jscrane/TinySensors/mqtt-tft/README.md

# MQTT-TFT
Graphical display of MQTT sensors.

## Hardware
Display hardware as [WifiWeatherGuy](https://cadlab.io/project/1280/master/files):
- [Wemos D1 Mini](https://wiki.wemos.cc/products:d1:d1_mini)
- PCB-mounted push switch
- 1.8" TFT LCD display

## Software
- [Arduino](https://www.arduino.cc/en/main/software) 1.8.x
- [Arduino/ESP8266](https://github.com/esp8266/Arduino) 2.7.4
- [ArduinoJson](https://arduinojson.org) 6.16.1
- [TFT_eSPI](https://github.com/Bodmer/TFT_eSPI) 2.2.20
- [SimpleTimer](https://github.com/schinken/SimpleTimer)
- [Stator](https://github.com/PTS93/Stator)
