jscrane/TinySensors/(threads)

Thread 1 (2018-05-24):

cleanup socket handling

jscrane, 2018-05-24:
Fix mux in same way as lcd in commit 83f410cbb7785c234b9e89145b753e38b5866409

Closed 2018-05-25.

Thread 2 (2019-02-18):

Tinysensor sketch improvements

jscrane, 2019-02-18:
- [x] remove pinMode for A1 (not needed)
- [x] remove setAutoAck (not needed)
- [x] constants for ports
- [x] pinMode(A1, INPUT_PULLUP)
- [x] fix sensortest sketch
- [x] setMaxRetries (to save batteries) --- use sensortest
- [x] use Interrupted instead of sleepy

jscrane, 2019-06-12:
See [this article](https://lastminuteengineers.com/nrf24l01-arduino-wireless-communication/) for some tips. In particular:
- maybe don't use RF24Network at all?
- channel frequency (so don't get interference from wifi)
- lower data rate

jscrane, 2019-06-20:
Don't think there's enough flash space for Interrupted. Use a slimmed-down wdt_sleep() instead (see sensortest.ino)

Closed 2019-06-21.

Thread 5 (2019-02-21):

investigate nRF24

jscrane, 2019-02-21:
[nRF24](https://github.com/nRF24/RF24) looks interesting.

jscrane, 2020-05-19:
Currently using in tinysensor.ino. Next step is to use in sensorhub.

Closed 2020-05-20.

Thread 13 (2020-09-15):

Clock ATtiny at 1MHz

jscrane, 2020-09-15:
This will require a new patched optiboot. The current patch assumes the frequency is 8MHz.

See `optiboot/bootloaders/optiboot/Makefile.extras`.

jscrane, 2020-09-16:
Have added infrastructure for this; however DHT doesn't work at 1MHz, for unknown reason.

jscrane, 2020-09-17:
From the [datasheet](https://cdn-shop.adafruit.com/datasheets/Digital+humidity+and+temperature+sensor+AM2302.pdf), the sensor sends 40 bits of data in which 0s are encoded as a pulse-high 26-28uS wide, while a 1 is encoded as a pulse-high 70uS wide. From the thread, the resolution of `micros()` is 64uS at 1MHz so polling is out.

Could use pin-change interrupts and direct reading of a higher-resolution timer (e.g., timer1).

Closed 2023-11-11.

Thread 14 (2020-09-28):

mqtt-tft graphing sketch

jscrane, 2020-09-28:
- [x] multiple graphs (current value, sprite)
- [x] switching between graphs
- [x] sensor labels name -> colours
- [x] current graph title
- [x] configuring individual graphs
- [x] 4-bit colour depth
- [x] graph config: min, max, refresh interval
- [ ] const strings in flash

Closed 2020-10-03.
