jscrane/TinySensors/eagle/sensors.brd

## EAGLE design eagle/sensors.brd (2019-02-17)

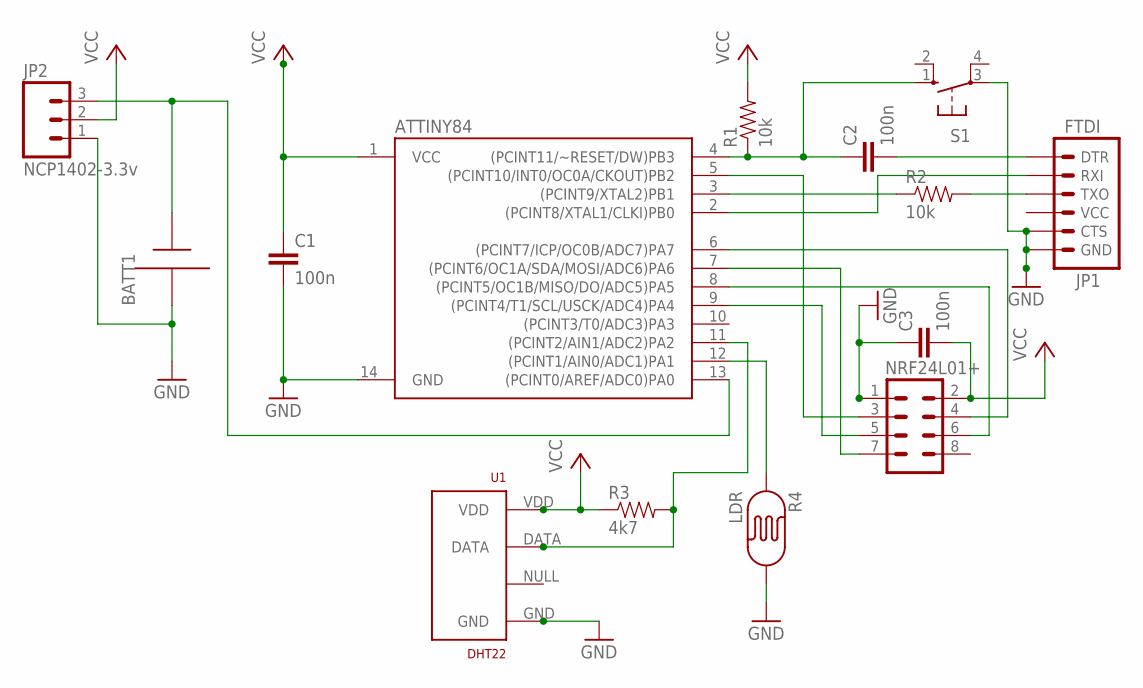
[picture p1: schematic sensors.sch]

Parts:
ATTINY84: ATTINY84ATTINY84-20PU; DIL14
BATT1: AAA; 12BH412
C1, C2, C3: 100n; CAP-PTH-5MM
JP1: FTDI; 1X06
JP2: NCP1402-3.3v; 1X03
NRF24L01+: M04X2; 2X4
R1, R2: 10k; AXIAL-0.3EZ
R3: 4k7; AXIAL-0.3EZ
R4: LDR; PHOTOCELL
S1: 10-XX; B3F-10XX
U1: DHT22; RHT03_DHT-22

Connections:
GND: ATTINY84.14 (GND), BATT1.-, C1.2, C3.1, JP1.5 (CTS), JP1.6 (GND), JP2.1, NRF24L01+.1, R4.2, S1.3, U1.GND
unnamed: ATTINY84.6 ((PCINT7/ICP/OC0B/ADC7)PA7), NRF24L01+.4
unnamed: ATTINY84.3 ((PCINT9/XTAL2)PB1), R2.P$1 (1)
unnamed: ATTINY84.4 ((PCINT11/~RESET/DW)PB3), C2.1, R1.P$1 (1), S1.1 (S)
unnamed: C2.2, JP1.1 (DTR)
unnamed: JP1.3 (TXO), R2.P$2 (2)
unnamed: ATTINY84.2 ((PCINT8/XTAL1/CLKI)PB0), JP1.2 (RXI)
unnamed: ATTINY84.7 ((PCINT6/OC1A/SDA/MOSI/ADC6)PA6), NRF24L01+.7
unnamed: ATTINY84.13 ((PCINT0/AREF/ADC0)PA0), BATT1.+, JP2.3
unnamed: ATTINY84.9 ((PCINT4/T1/SCL/USCK/ADC4)PA4), NRF24L01+.5
unnamed: ATTINY84.12 ((PCINT1/AIN0/ADC1)PA1), R4.1
unnamed: ATTINY84.11 ((PCINT2/AIN1/ADC2)PA2), R3.P$2 (2), U1.DATA
unnamed: ATTINY84.8 ((PCINT5/OC1B/MISO/DO/ADC5)PA5), NRF24L01+.6
unnamed: ATTINY84.5 ((PCINT10/INT0/OC0A/CKOUT)PB2), NRF24L01+.3
VCC: ATTINY84.1 (VCC), C1.1, C3.2, JP2.2, NRF24L01+.2, R1.P$2 (2), R3.P$1 (1), U1.VDD

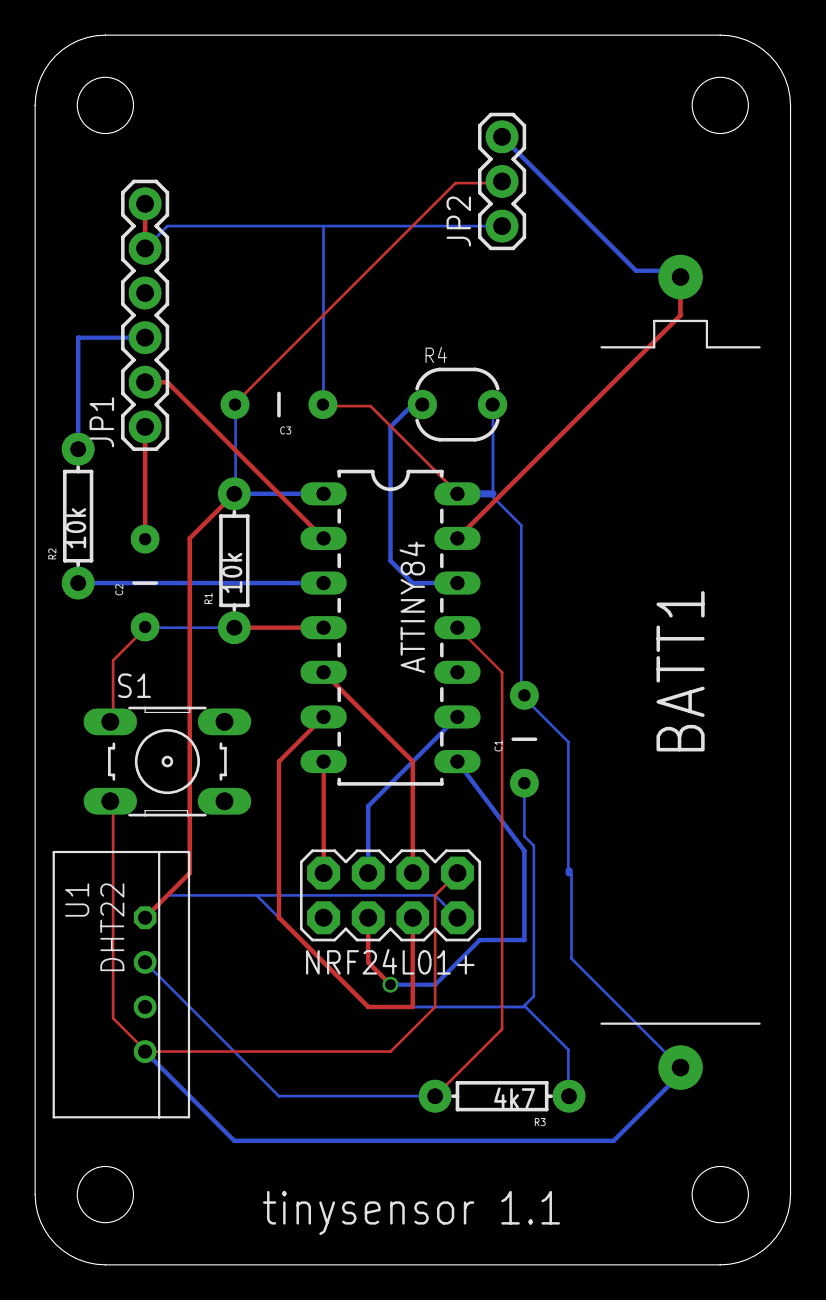
[picture p2: board sensors.brd from above]

Board: 2 copper layers, 43.0 x 70.0 mm, 15 parts (0 on the bottom side), 15 nets.

Other parts of the board:
U$1: DP7043_V1
