jscrane/TinySensors/tinysensor/tinysensor.h

#ifndef TINYSENSOR_H
#define TINYSENSOR_H

// shared with sensorhub
const uint8_t channel = 110;
const rf24_datarate_e data_rate = RF24_250KBPS;
const rf24_crclength_e crc_len = RF24_CRC_16;

const uint64_t bridge_addr = 0xF0F0F0F0E1LL;

struct sensor_payload_t
{
	uint32_t ms, id;
	int16_t humidity, temperature;
	uint8_t node_id, light, battery, status;
};

#endif
