jscrane/TinySensors/(commit log)

2014-02-07 add Eagle files
    [sensors.brd, sensors.sch]
2014-02-07 make capacitors bigger
    [sensors.brd, sensors.sch]
2014-02-10 compute proper rolling average filter outliers menus to select device and parameter
2014-02-11 - adding canned time periods - radio-buttons in menus
2014-02-19 add remote socket interface
2014-02-20 add device type
2014-02-20 pretty print to socket
2014-02-20 re-added sensortest submodule
2014-02-24 remove device_type_id from sensordata table
2014-02-25 adding device capabilities
2014-02-25 - using device_type to enable locations which possess a particular sensor
2014-05-16 share auth with sensorhub
2014-08-13 - x-axis label becomes start-date - busy-cursor for plot creation - update deps
2015-02-08 break out sensorlib
2015-02-08 cleanup sensorhub a bit add new fields to sensor_t
2015-02-08 add mysqlmux mux client, remove functionality from sensorhub
2015-02-09 cache readings at mux and hand them out to new clients mux clients handle its failure properly now other bugfixes
    [lcd.cpp, mux.cpp, mysql.cpp, sensorlib.cpp, sensorlib.h]
2015-02-09 software fix for hardware error
    [sensorhub.cpp]
2015-02-10 add status lcd driver
2015-02-11 sensorhub uses same format as mux
2015-02-11 make sensor_t a class
2015-02-12 mux data from wireless and wired
2015-02-12 new wired sensors server script
2015-02-12 mysql guy only writes fields appropriate for sensor
2015-02-13 lcd manages both sensor screens
2015-02-16 renumbering sensors
2015-03-18 mux passes around sensor's short name
    [lcd.cpp, mux.cpp, sensorlib.cpp, sensorlib.h]
2015-03-19 improve sensordb api
2015-03-27 mux attempts reconnect to failed upstream server, non-blocking bugfix daemon_mode
    [lcd.cpp, mux.cpp, mysql.cpp, rrd.cpp, sensorlib.cpp, sensorlib.h, status.cpp]
2015-07-13 move on_connect() into sensorlib
2016-01-16 blank sensor not heard from recently
2016-12-13 configure sensor names from file
2017-10-10 board layout v1.1
    [sensors.brd, sensors.sch]
2018-05-08 display battery
2018-05-24 better socket handling
2018-05-25 cleanup socket handling
2018-10-25 close lcd socket on write error
    [lcd.cpp]
2019-02-17 switch to git@ for submodules
2019-02-20 remove sensortest submodule
2019-02-21 change retry interval (to save battery)
2019-03-11 switch to openweathermap
2019-03-15 die if cannot read weather file
2019-06-17 board definition for tinysensor
2019-06-17 fix for arduino ide
2019-06-22 print details explicitly
2019-06-22 call out defaults for power and crc_len
2020-01-31 esp8266 bridge
    [Configuration.h]
2020-05-08 rf24bridge + sensor w/o RF24Network
2020-05-15 working sensorhub + fix compiler warnings
    [sensorhub.cpp, sensorlib.cpp]
2020-05-15 rewire board
2020-05-16 add Test Sensor to Domoticz
2020-05-17 power bugfix
2020-05-20 remove sensortest + rename sketches -> tinysensor
2020-05-27 rename sensor
2020-07-09 place unit beside last-updated sensor
2020-08-17 disable adc before sleeping
2020-09-09 more power-saving: disable usi and timer1, turn off light pullup except when read
2020-09-26 rough initial cut of mqtt graphing sketch
    [configuration.h]
2020-09-30 add graph_config
    [configuration.h]
2020-10-04 remove debug flag from config
    [configuration.h]
2020-11-23 disable all devices before wdt
2021-04-30 battery stats
    [batt.csv]
2021-10-01 'host not found' can be transient error if it's rebooting
    [lcd.cpp, mux.cpp, sensorlib.cpp]
2022-08-09 lcdproc owm client
    [batt.csv]
2023-11-10 Wireless (#17)
    * remove sheeva from mux. remove wired sensors from nodes.txt.
    * add toggles to enable/disable wireless/wired sensor display for lcd
    * update to crc16
    [batt.csv]
2023-11-10 Wireless (#18)
    * battery
    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
    [batt.csv]
